perrinebeurier/BMI-EMG-HW/Board V4/DecodingBoard/3D models KiCad/FTSH-107-01-L-D-RA.stp

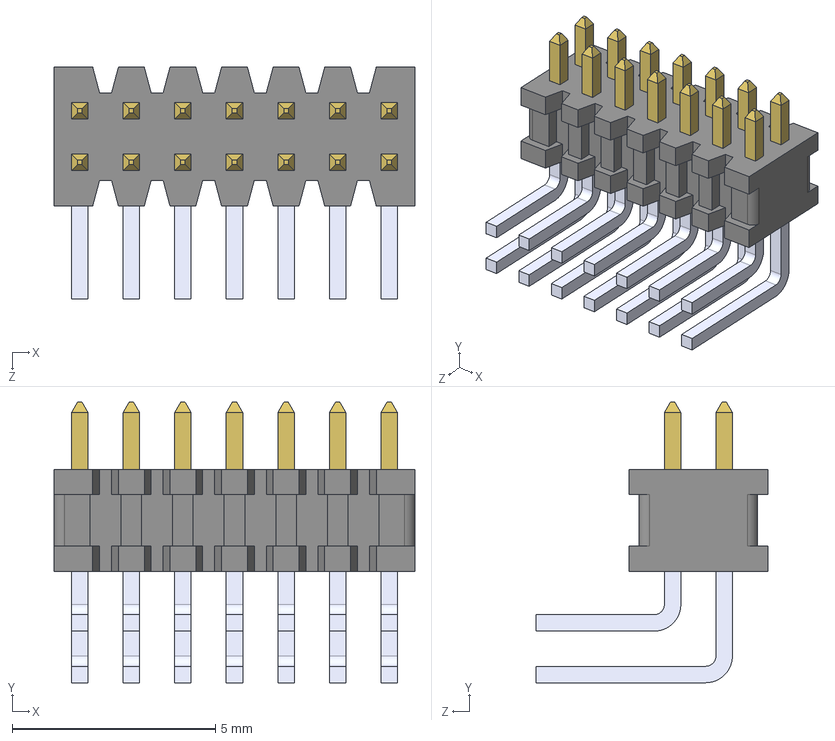
[picture p1: CAD file, 2026-10-09]
Board V4/DecodingBoard/3D models KiCad/FTSH-107-01-L-D-RA.stp
8.89 x 6.91 x 5.71 mm
