perrinebeurier/BMI-EMG-HW/Board V4/DecodingBoard/3D models KiCad/ESDS302DBVR.stp

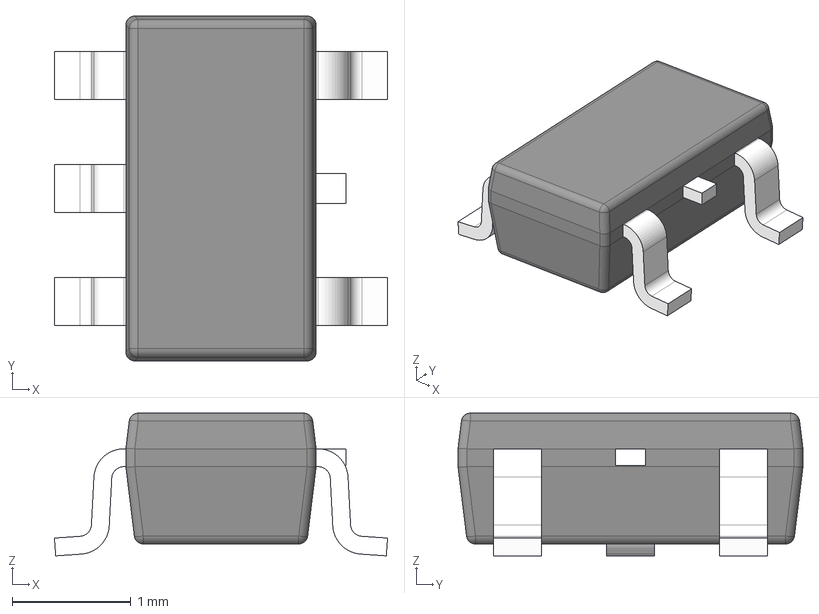
[picture p2: CAD file, 2026-10-08]
Board V4/DecodingBoard/3D models KiCad/ESDS302DBVR.stp
2.80 x 2.90 x 1.20 mm
BODY-SOT
LEAD-SOT x 5
LEAD-DUMMY
