perrinebeurier/BMI-EMG-HW/Board V4/DecodingBoard/3D models KiCad/CX2016DB32000D0FLJCC.stp

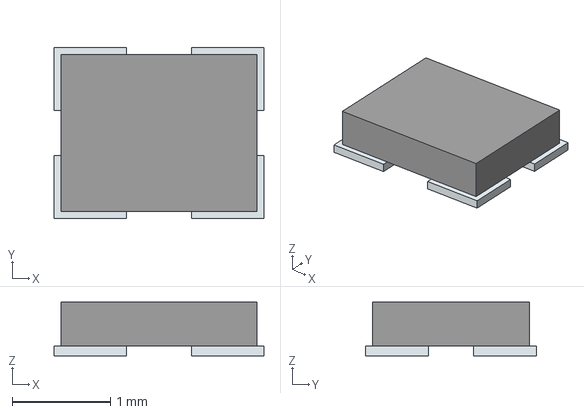
[picture p3: CAD file, 2026-10-08]
Board V4/DecodingBoard/3D models KiCad/CX2016DB32000D0FLJCC.stp
2.14 x 1.74 x 0.55 mm
Pins
