perrinebeurier/BMI-EMG-HW/Board V4/DecodingBoard/3D models KiCad/TL3305BF100QG.stp

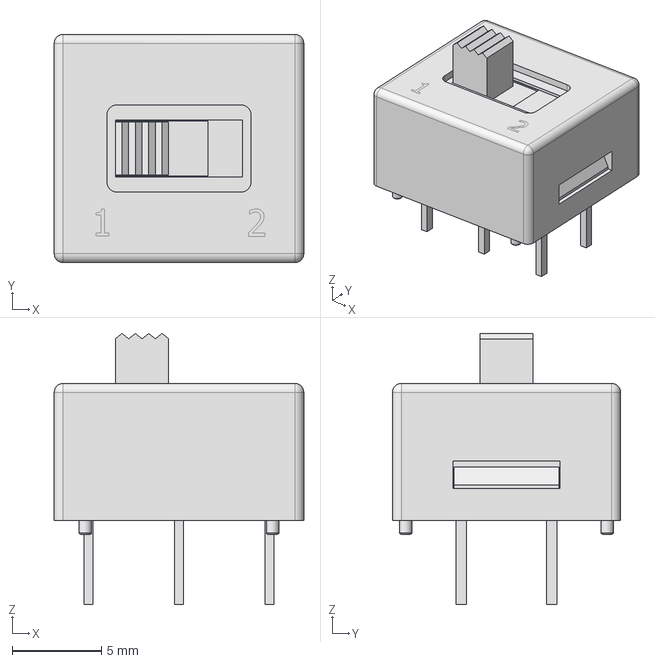
[picture p4: CAD file, 2026-10-08]
Board V4/DecodingBoard/3D models KiCad/TL3305BF100QG.stp
14.0 x 12.8 x 15.2 mm
