perrinebeurier/BMI-EMG-HW/Board V4/DecodingBoard/3D models KiCad/TPS7A7200RGWT.stp

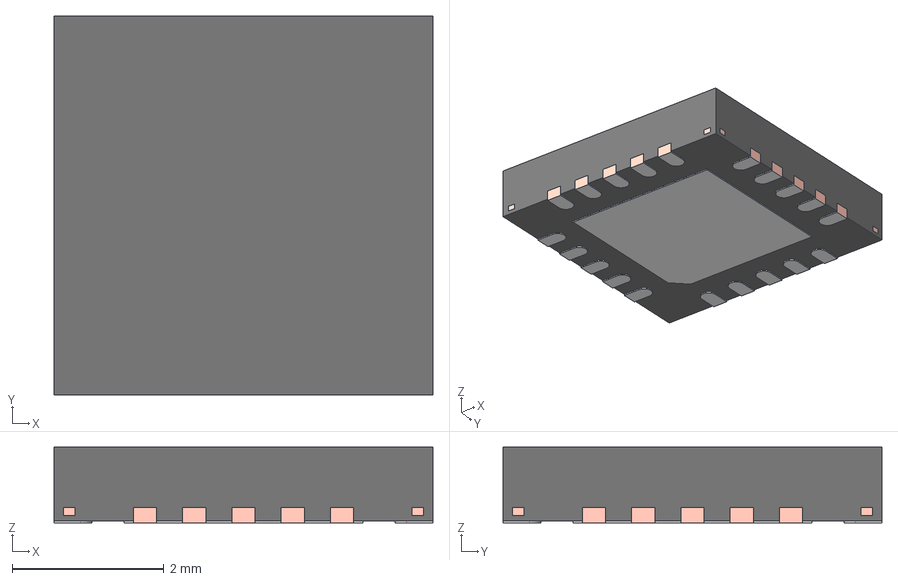
[picture p5: CAD file, 2026-10-08]
Board V4/DecodingBoard/3D models KiCad/TPS7A7200RGWT.stp
5.00 x 5.00 x 1.00 mm
FRAME
PIN1_AREA
