perrinebeurier/BMI-EMG-HW/Board V4/DecodingBoard/3D models KiCad/UJ20-C-H-G-SMT-1-P16-TR.step

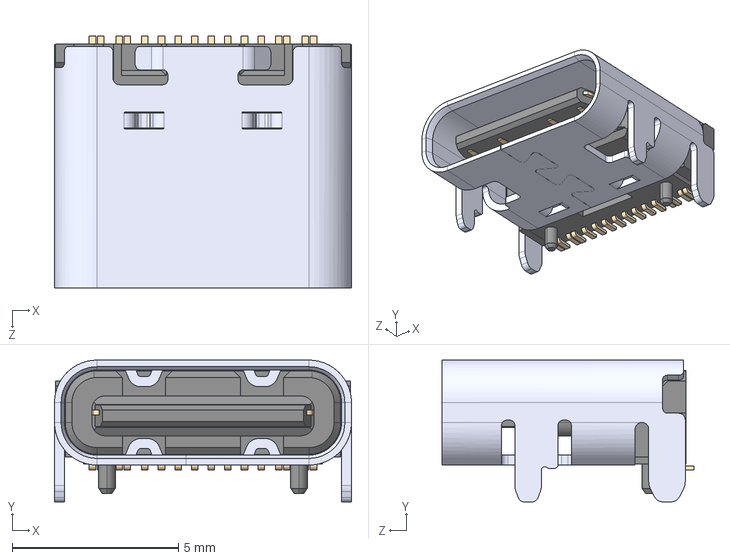
[picture p6: CAD file, 2026-10-08]
Board V4/DecodingBoard/3D models KiCad/UJ20-C-H-G-SMT-1-P16-TR.step
8.94 x 4.27 x 7.60 mm
