perrinebeurier/BMI-EMG-HW/Board V4/DecodingBoard/3D models KiCad/TPS2121RUXR.stp

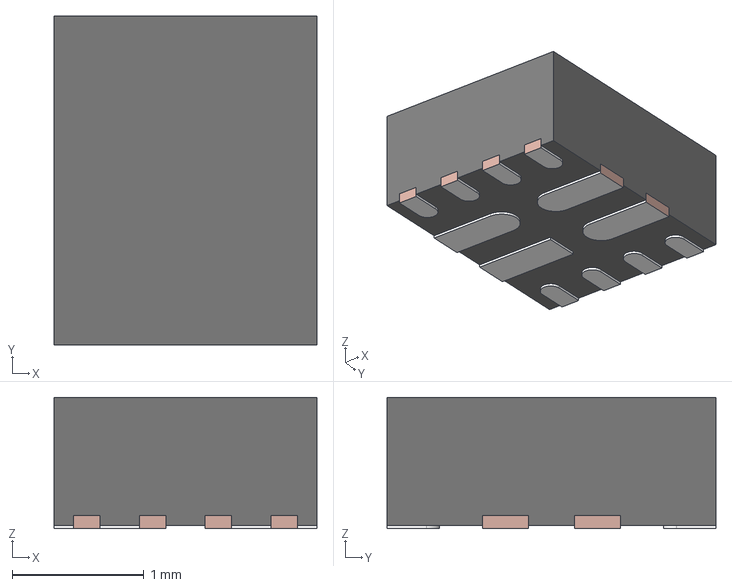
[picture p7: CAD file, 2026-10-08]
Board V4/DecodingBoard/3D models KiCad/TPS2121RUXR.stp
2.00 x 2.50 x 1.00 mm
FRAME
MOLD
