perrinebeurier/BMI-EMG-HW/Board V4/DecodingBoard/3D models KiCad/STM32WBA65CIU6.stp

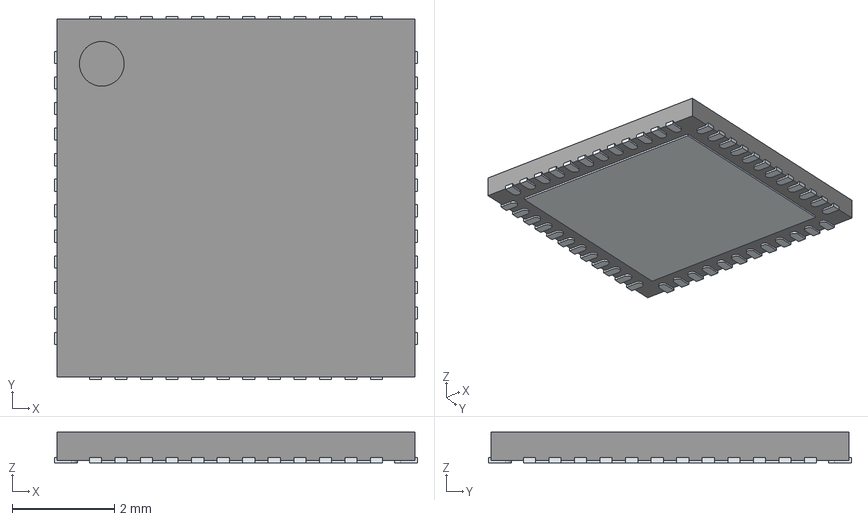
[picture p8: CAD file, 2026-10-08]
Board V4/DecodingBoard/3D models KiCad/STM32WBA65CIU6.stp
7.10 x 7.10 x 0.6 mm
ThermalPin
PinsArrayLR
PinsArrayTB
