perrinebeurier/BMI-EMG-HW/Board V4/DecodingBoard/3D models KiCad/TO-92_MC_MCH.step

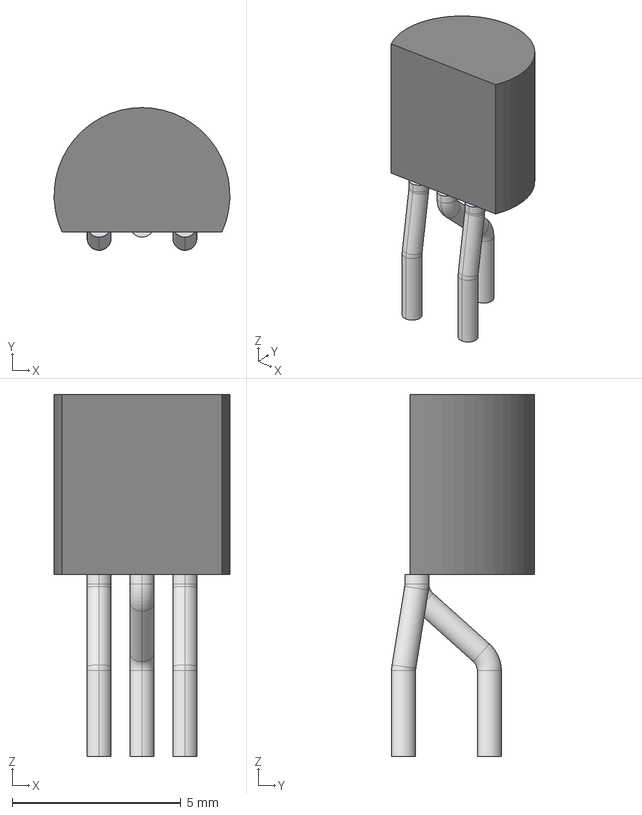
[picture p9: CAD file, 2026-10-08]
Board V4/DecodingBoard/3D models KiCad/TO-92_MC_MCH.step
5.20 x 4.23 x 10.7 mm
