perrinebeurier/BMI-EMG-HW/Board V4/DecodingBoard/3D models KiCad/RN4871-V_RM140.stp

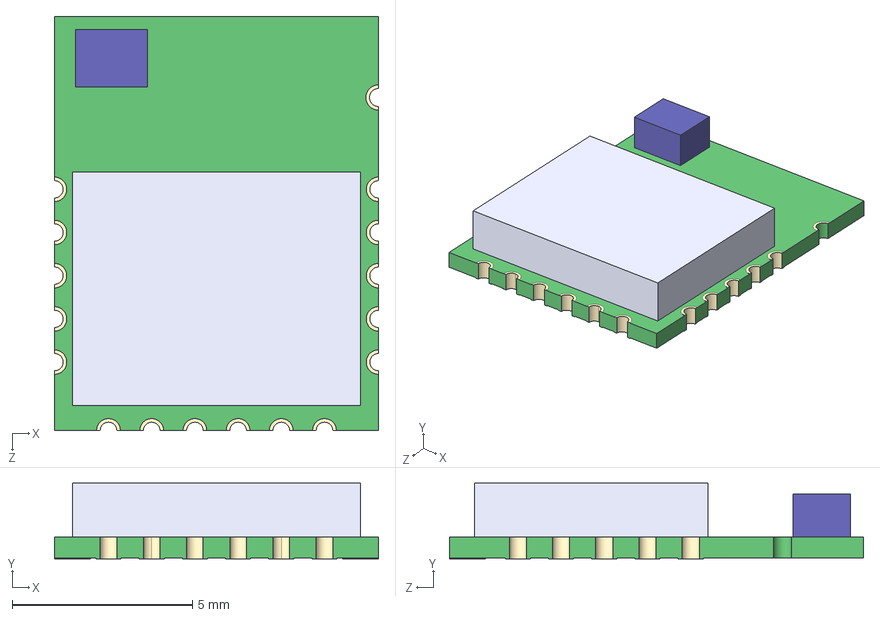
[picture p10: CAD file, 2026-10-08]
Board V4/DecodingBoard/3D models KiCad/RN4871-V_RM140.stp
9.00 x 2.10 x 11.5 mm
