perrinebeurier/BMI-EMG-HW/Board V4/DecodingBoard/3D models KiCad/TSM-106-02-T-SH-LC.step

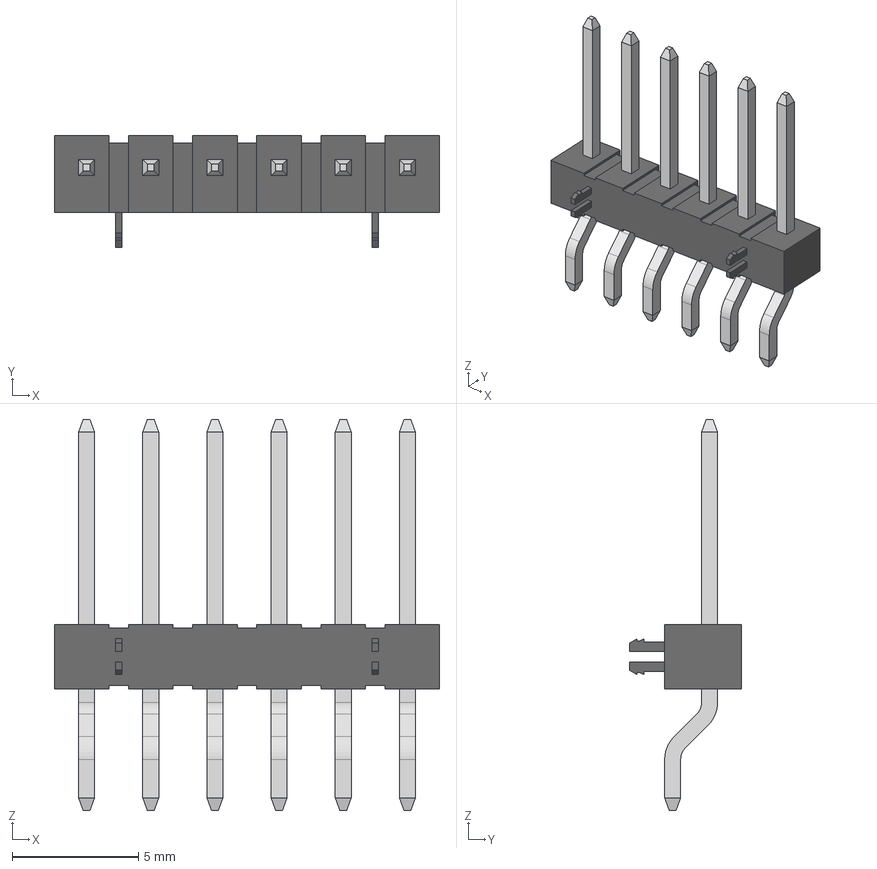
[picture p11: CAD file, 2026-10-08]
Board V4/DecodingBoard/3D models KiCad/TSM-106-02-T-SH-LC.step
15.2 x 4.44 x 15.5 mm
TSM-106-02-SH-LC_body
T-1S6-15-T(-02-6-SH)
T-1S6-15-T(-02-6-SH)2
