perrinebeurier/BMI-EMG-HW/Board V4/DecodingBoard/3D models KiCad/TL3305BFxxxxG.stp

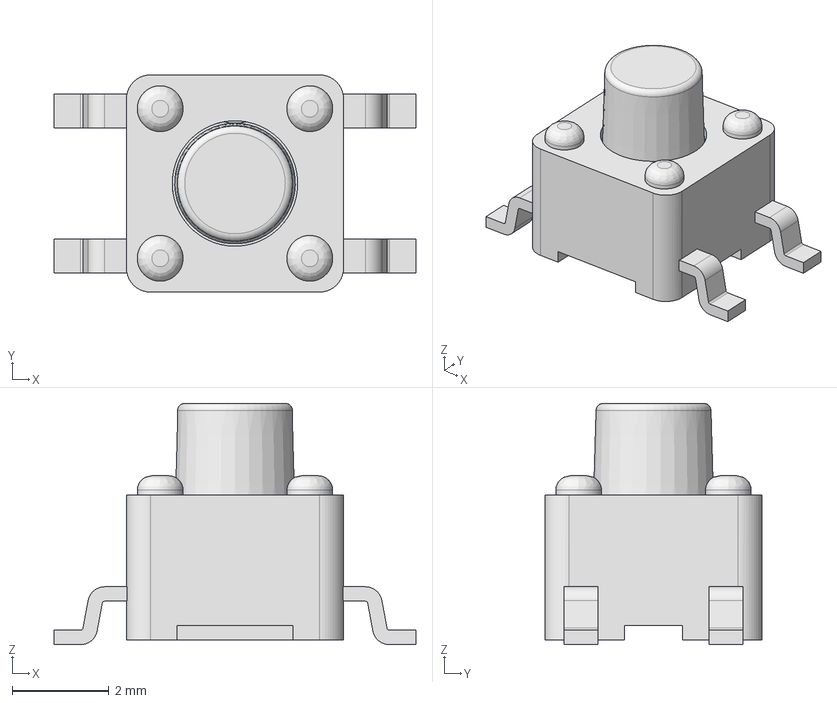
[picture p12: CAD file, 2026-10-08]
Board V4/DecodingBoard/3D models KiCad/TL3305BFxxxxG.stp
7.50 x 4.50 x 5.00 mm
