perrinebeurier/BMI-EMG-HW/Board V4/DecodingBoard/3D models KiCad/2053380002.stp

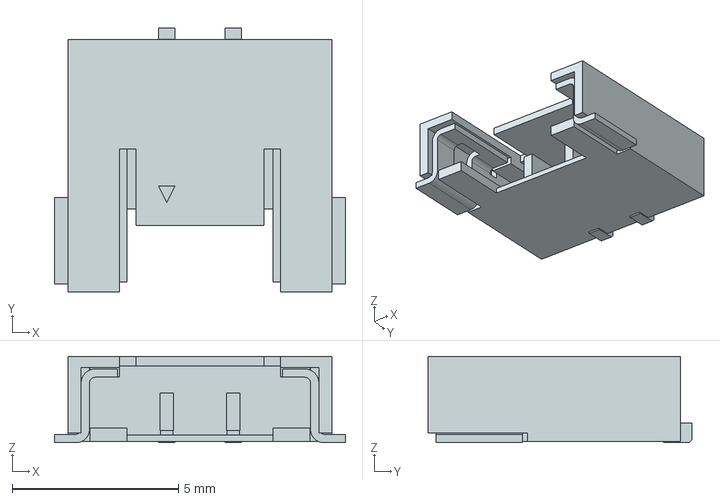
[picture p13: CAD file, 2026-10-08]
Board V4/DecodingBoard/3D models KiCad/2053380002.stp
8.75 x 7.95 x 2.60 mm
