perrinebeurier/BMI-EMG-HW/Board V4/DecodingBoard/3D models KiCad/5037630491.stp

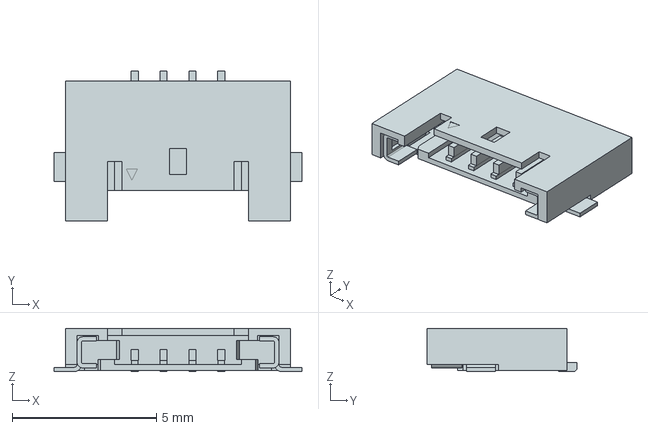
[picture p14: CAD file, 2026-10-08]
Board V4/DecodingBoard/3D models KiCad/5037630491.stp
8.60 x 5.19 x 1.50 mm
