perrinebeurier/BMI-EMG-HW/Board V4/DecodingBoard/3D models KiCad/5040500491.stp

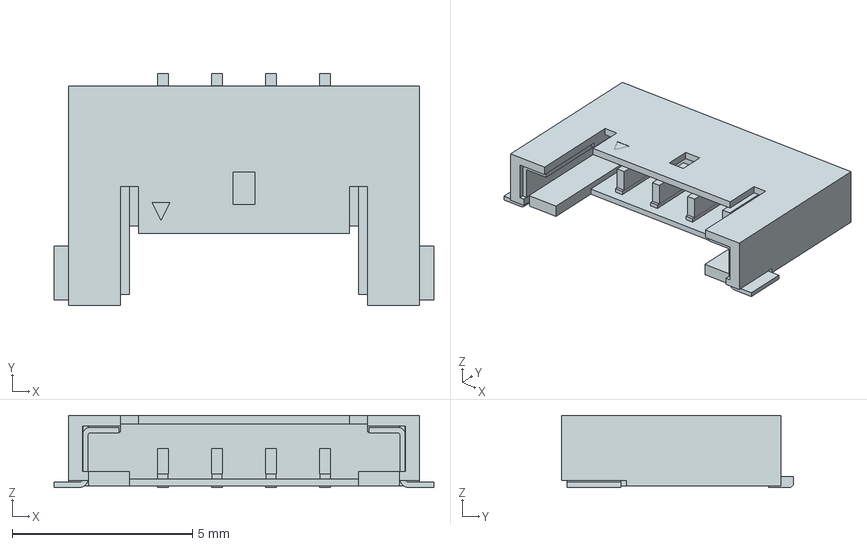
[picture p15: CAD file, 2026-10-08]
Board V4/DecodingBoard/3D models KiCad/5040500491.stp
10.6 x 6.44 x 2.00 mm
