perrinebeurier/BMI-EMG-HW/Board V4/DecodingBoard/DecodingBoard.kicad_pcb

## KiCad design Board V4/DecodingBoard/DecodingBoard.kicad_pcb (2026-10-09)

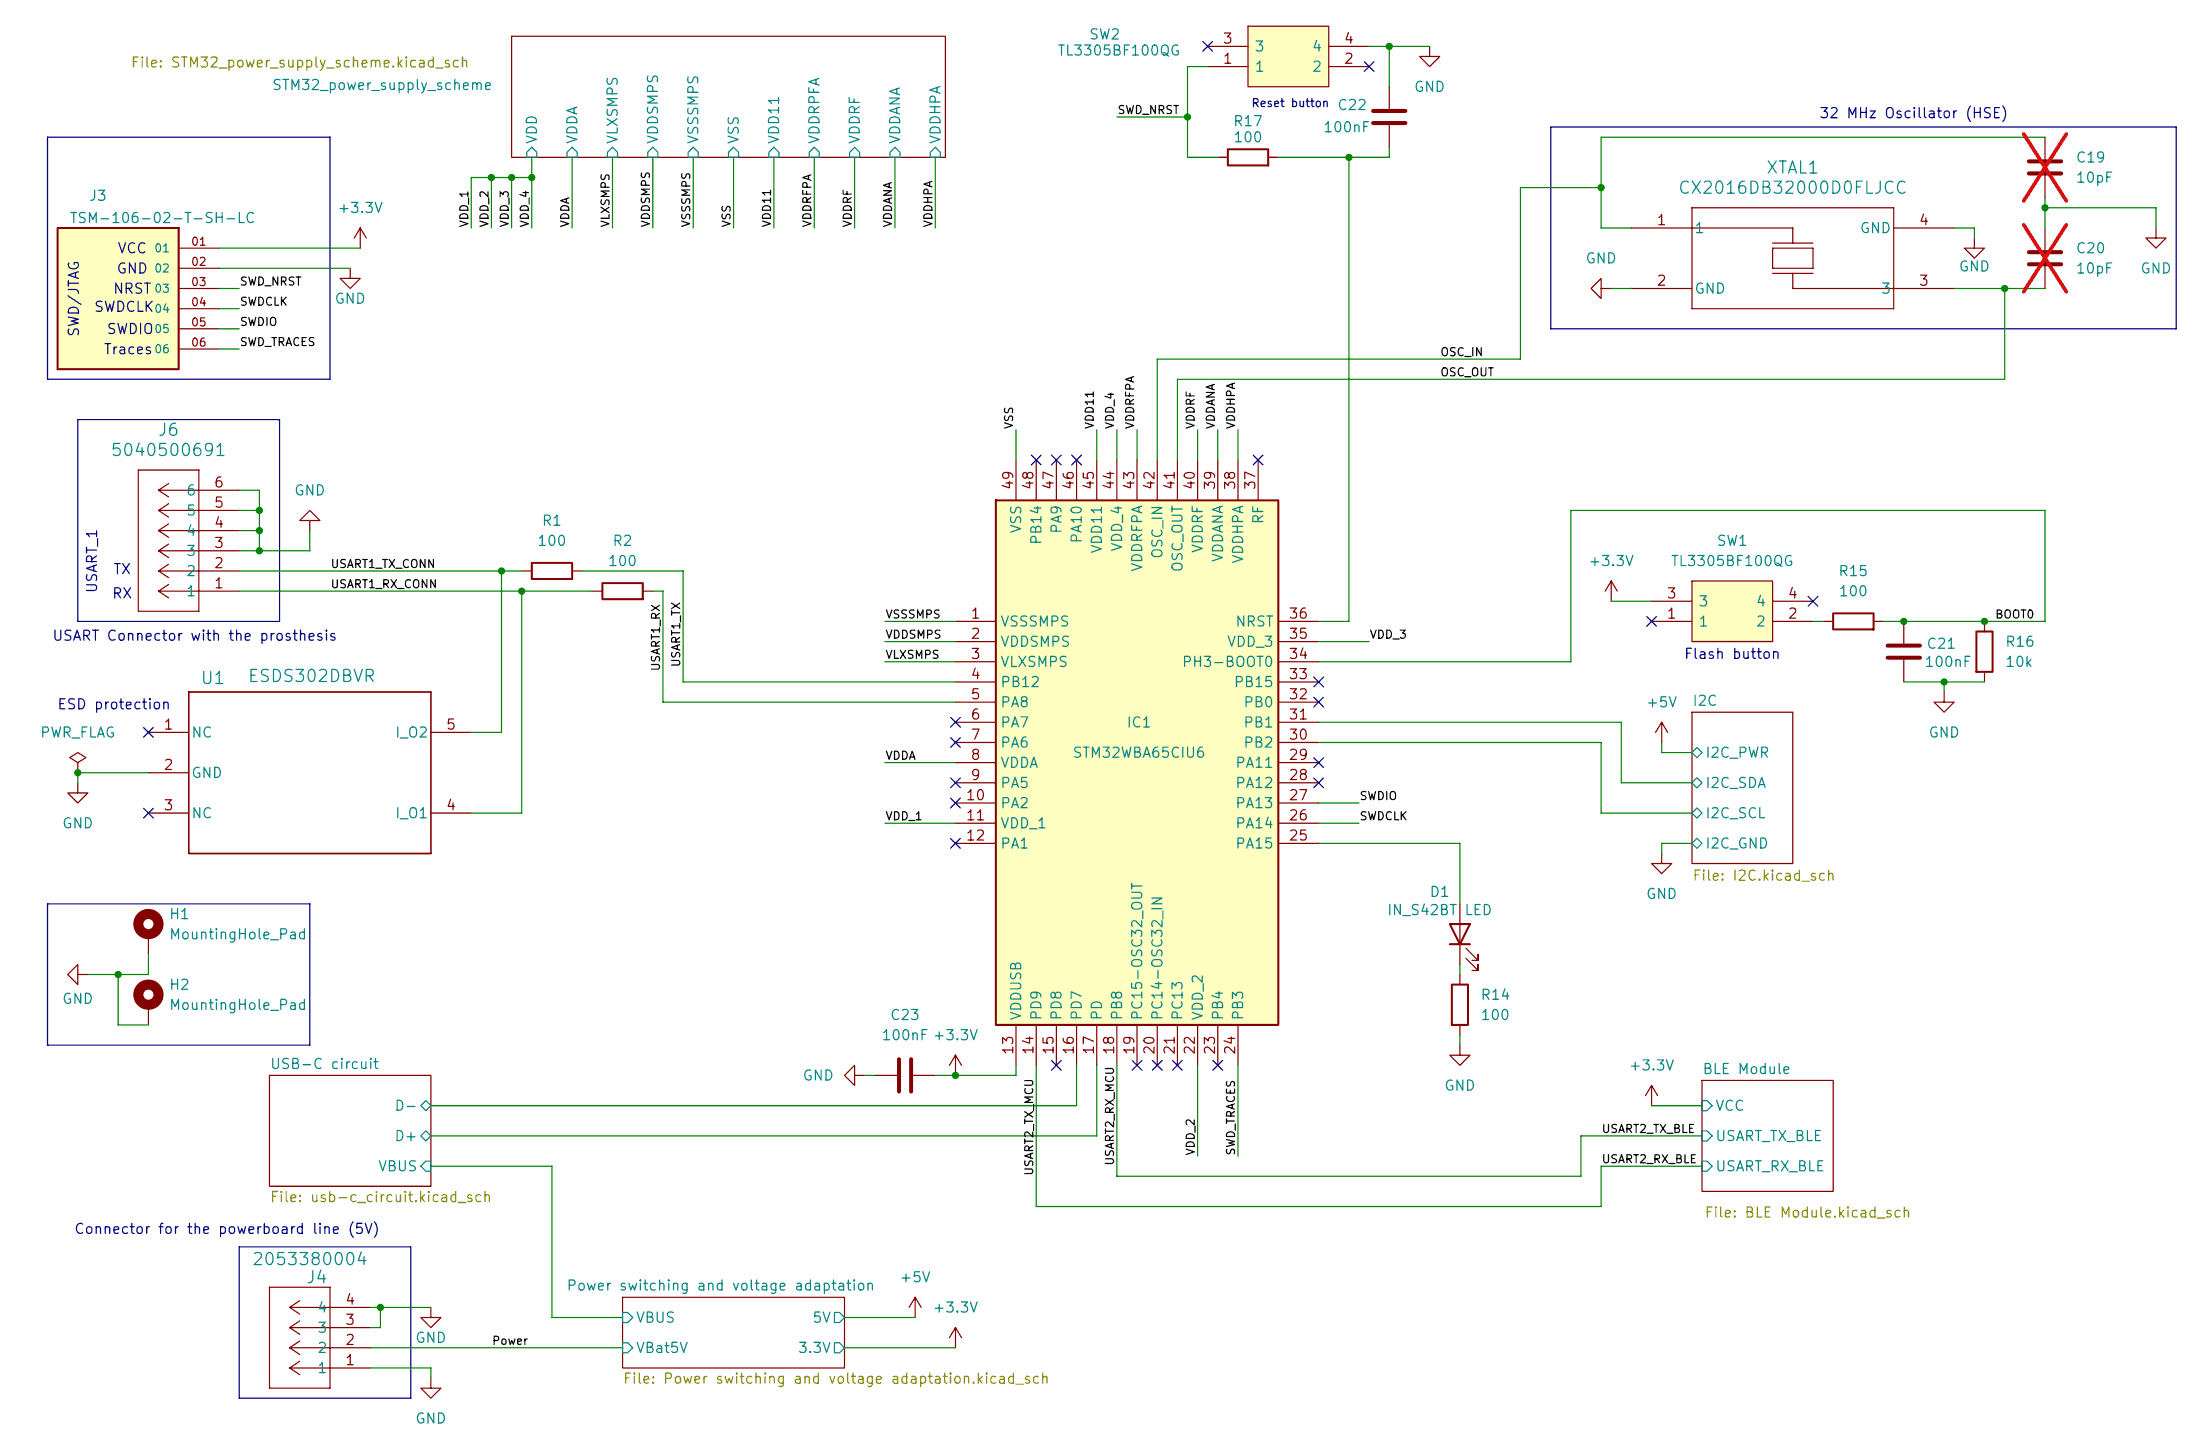
[picture p16: schematic DecodingBoard.kicad_sch, Decoding Board]

Parts:
C19, C20: 10pF; C_0603_1608Metric; not fitted
C21, C22, C23: 100nF; C_0402_1005Metric
D1: IN_S42BT LED; LED_0402_1005Metric
H1, H2: MountingHole_Pad; MountingHole_2.2mm_M2_DIN965_Pad
IC1: STM32WBA65CIU6; QFN50P700X700X60-49N-D; Manufacturer_Part_Number STM32WBA65CIU6; Mouser Part Number 511-STM32WBA65CIU6
J3: TSM-106-02-T-SH-LC; SAMTEC_TSM-106-02-T-SH-LC; PARTREV R
J4: 2053380004; CONN_2053380000-SD_02_MOL
J6: 5040500691; CONN_5040500491_MOL
R1, R2, R14, R15, R17: 100; R_0402_1005Metric
R16: 10k; R_0402_1005Metric
SW1, SW2: TL3305BF100QG; TL3305BF160QG; Mouser Part Number 612-TL3305BF100QG
U1: ESDS302DBVR; SOT95P280X145-5N; Mouser Part Number 595-ESDS302DBVR
XTAL1: CX2016DB32000D0FLJCC; Mouser Part Number 581-CX2016DB32DFLJCC

Connections:
+3.3V: C23.2, IC1.2 (VDDSMPS), IC1.8 (VDDA), IC1.11 (VDD_1), IC1.13 (VDDUSB), IC1.22 (VDD_2), IC1.35 (VDD_3), IC1.40 (VDDRF), IC1.44 (VDD_4), J3.01, SW1.3; also elsewhere on the board
/BOOT0: C21.1, IC1.34 (PH3-BOOT0), R15.2, R16.1
/I2C/I2C_SCL: IC1.30 (PB2); also elsewhere on the board
/I2C/I2C_SDA: IC1.31 (PB1); also elsewhere on the board
/OSC_IN: C19.1, IC1.42 (OSC_IN), XTAL1.1
/OSC_OUT: C20.2, IC1.41 (OSC_OUT), XTAL1.3
/Power: J4.2; also elsewhere on the board
/SWDCLK: IC1.26 (PA14), J3.04
/SWDIO: IC1.27 (PA13), J3.05
/SWD_NRST: J3.03, R17.1, SW2.1
/SWD_TRACES: IC1.24 (PB3), J3.06
/USART1_RX: IC1.5 (PA8), R2.2
/USART1_RX_CONN: J6.1, R2.1, U1.4 (I_O1)
/USART1_TX: IC1.4 (PB12), R1.2
/USART1_TX_CONN: J6.2, R1.1, U1.5 (I_O2)
/USART2_RX_BLE: IC1.14 (PD9); also elsewhere on the board
/USART2_RX_MCU: IC1.18 (PB8); also elsewhere on the board
/USB-C circuit/D+: IC1.17 (PD); also elsewhere on the board
/USB-C circuit/D-: IC1.16 (PD7); also elsewhere on the board
/VDD11: IC1.39 (VDDANA), IC1.43 (VDDRFPA), IC1.45 (VDD11); also elsewhere on the board
/VDDHPA: IC1.38 (VDDHPA); also elsewhere on the board
/VLXSMPS: IC1.3 (VLXSMPS); also elsewhere on the board
GND: C19.2, C20.1, C21.2, C22.2, C23.1, H1.1 (1_1), H2.1 (1_1), IC1.1 (VSSSMPS), IC1.49 (VSS), J3.02, J4.1, J4.3, J4.4, J6.3, J6.4, J6.5, J6.6, R14.2, R16.2, SW2.4, U1.2 (GND), XTAL1.2 (GND), XTAL1.4 (GND); also elsewhere on the board
unnamed: D1.2 (A), IC1.25 (PA15)
unnamed: D1.1 (K), R14.1
unnamed: C22.1, IC1.36 (NRST), R17.2
unnamed: R15.1, SW1.2

Notes on the sheet:
GND
SWDIO
Flash button
NRST
ESD protection
Traces
USART Connector with the prosthesis
USART_1
SWD/JTAG
Connector for the powerboard line (5V)
SWDCLK
VCC
Reset button
32 MHz Oscillator (HSE)

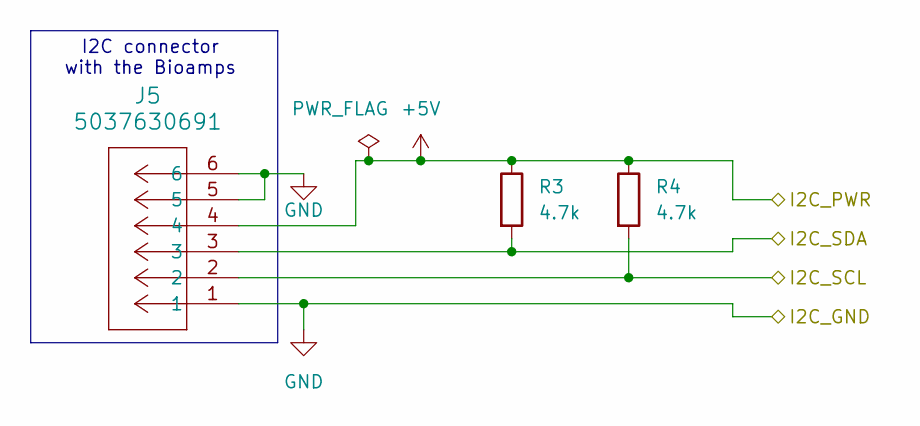
[picture p17: schematic I2C.kicad_sch]

Parts:
J5: 5037630691; CONN_5037630000-SD_04_MOL
R3, R4: 4.7k; R_0603_1608Metric

Connections:
+5V: J5.4, R3.1, R4.1; also elsewhere on the board
/I2C/I2C_SCL: J5.2, R4.2; also elsewhere on the board
/I2C/I2C_SDA: J5.3, R3.2; also elsewhere on the board
GND: J5.1, J5.5, J5.6; also elsewhere on the board

Notes on the sheet:
I2C connector with the Bioamps

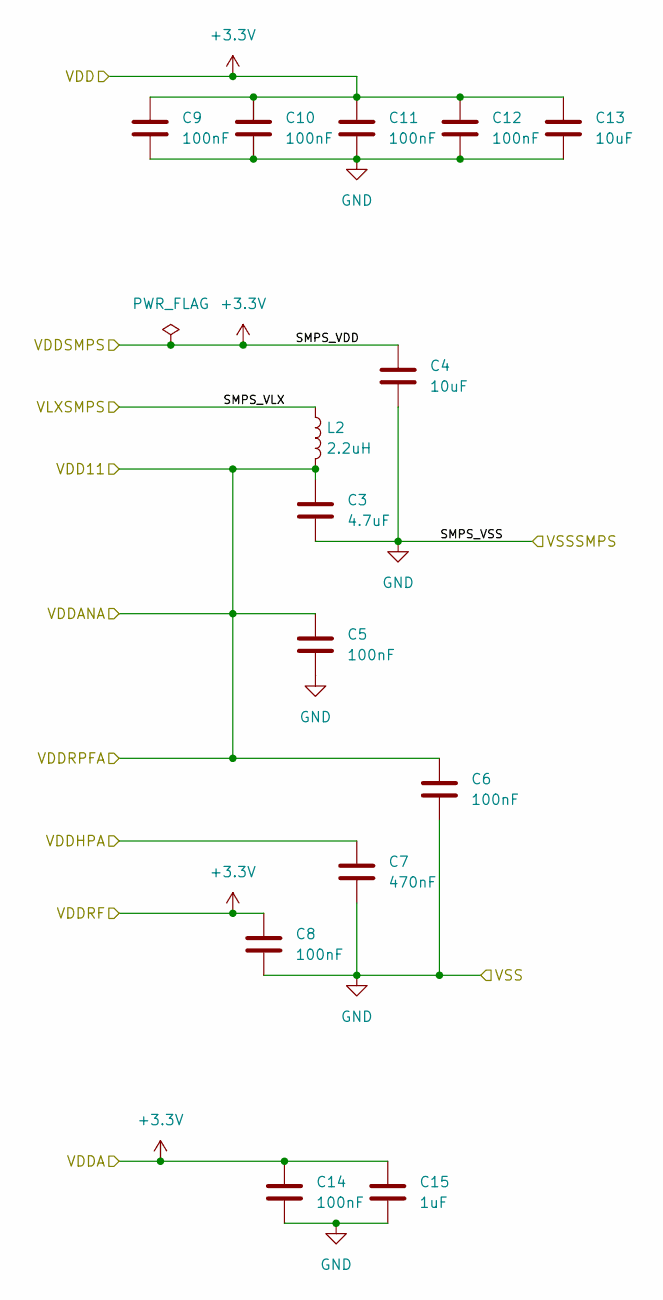
[picture p18: schematic STM32_power_supply_scheme.kicad_sch, STM32 Power Supply Scheme]

Parts:
C3: 4.7uF; C_0603_1608Metric
C4, C13: 10uF; C_0603_1608Metric
C5, C6, C8, C9, C10, C11, C12, C14: 100nF; C_0402_1005Metric
C7: 470nF; C_0402_1005Metric
C15: 1uF; C_0402_1005Metric
L2: 2.2uH; L_0805_2012Metric

Connections:
+3.3V: C4.1, C8.1, C9.1, C10.1, C11.1, C12.1, C13.1, C14.1, C15.1; also elsewhere on the board
/VDD11: C3.1, C5.1, C6.1, L2.2; also elsewhere on the board
/VDDHPA: C7.1; also elsewhere on the board
/VLXSMPS: L2.1; also elsewhere on the board
GND: C3.2, C4.2, C5.2, C6.2, C7.2, C8.2, C9.2, C10.2, C11.2, C12.2, C13.2, C14.2, C15.2; also elsewhere on the board

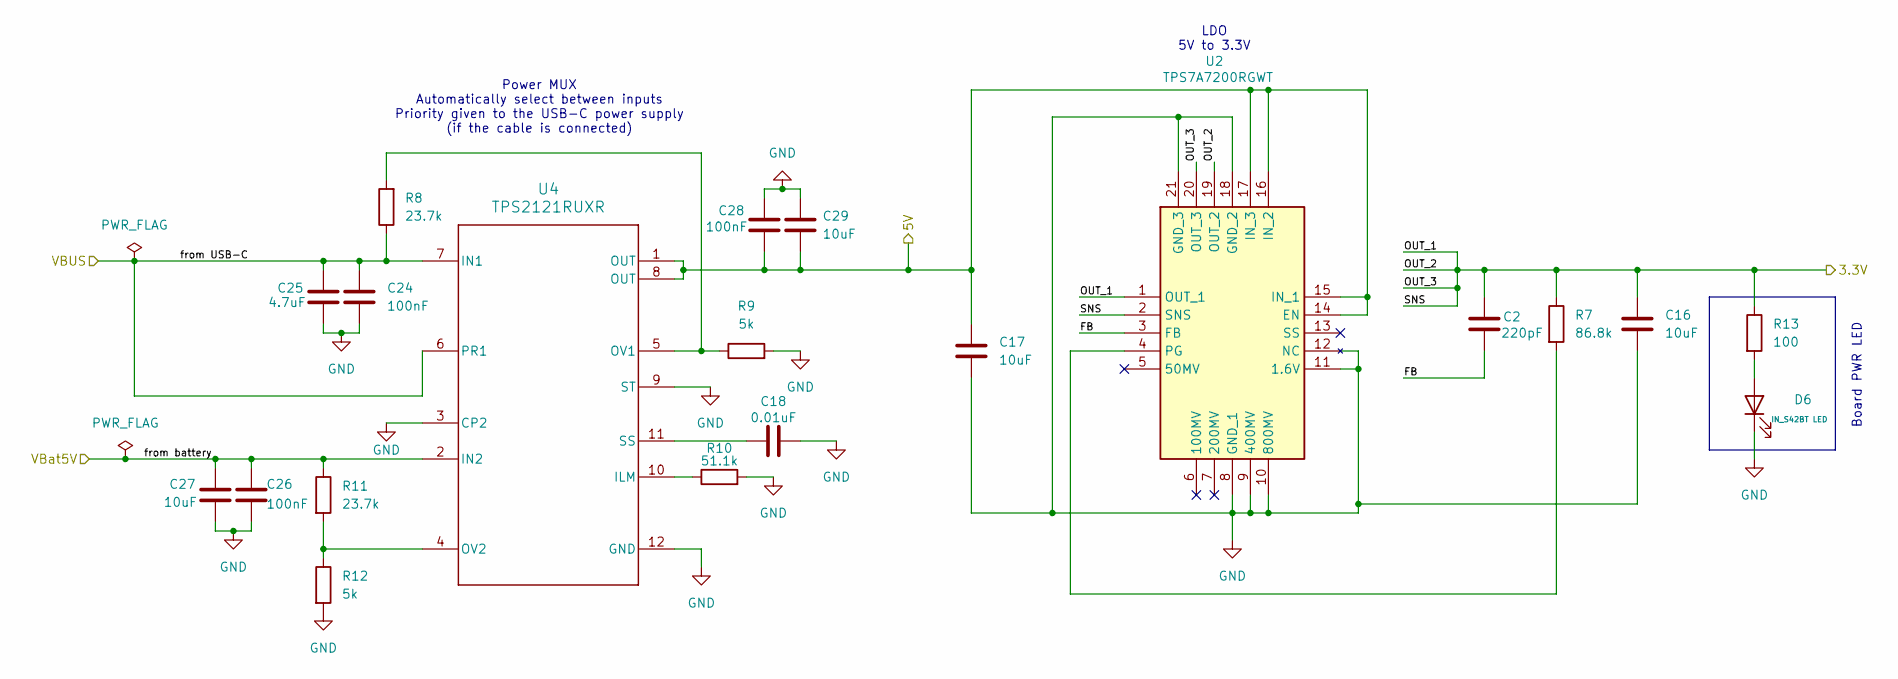
[picture p19: schematic Power switching and voltage adaptation.kicad_sch]

Parts:
C2: 220pF; C_0402_1005Metric
C16, C17, C27, C29: 10uF; C_0603_1608Metric
C18: 0.01uF; C_0402_1005Metric
C24, C26, C28: 100nF; C_0402_1005Metric
C25: 4.7uF; C_0603_1608Metric
D6: IN_S42BT LED; LED_0402_1005Metric
R7: 86.8k; R_0603_1608Metric
R8, R11: 23.7k; R_0402_1005Metric
R9, R12: 5k; R_0402_1005Metric
R10: 51.1k; R_0402_1005Metric
R13: 100; R_0402_1005Metric
U2: TPS7A7200RGWT; QFN65P500X500X100-21N-D; Manufacturer_Part_Number TPS7A7200RGWT; Mouser Part Number 595-TPS7A7200RGWT
U4: TPS2121RUXR; Mouser Part Number 595-TPS2121RUXR

Connections:
+3.3V: C2.1, C16.1, R7.1, R13.1, U2.1 (OUT_1), U2.2 (SNS), U2.19 (OUT_2), U2.20 (OUT_3); also elsewhere on the board
+5V: C17.1, C28.2, C29.2, U2.14 (EN), U2.15 (IN_1), U2.16 (IN_2), U2.17 (IN_3), U4.1 (OUT), U4.8 (OUT); also elsewhere on the board
/Power: C26.1, C27.1, R11.1, U4.2 (IN2); also elsewhere on the board
/Power switching and voltage adaptation/FB: C2.2, U2.3 (FB)
/Power switching and voltage adaptation/from USB-C: C24.1, C25.1, R8.1, U4.6 (PR1), U4.7 (IN1); also elsewhere on the board
GND: C16.2, C17.2, C18.2, C24.2, C25.2, C26.2, C27.2, C28.1, C29.1, D6.1 (K), R9.2, R10.2, R12.2, U2.8 (GND_1), U2.9 (400MV), U2.10 (800MV), U2.11 (1.6V), U2.12 (NC), U2.18 (GND_2), U2.21 (GND_3), U4.3 (CP2), U4.9 (ST), U4.12 (GND); also elsewhere on the board
unnamed: D6.2 (A), R13.2
unnamed: R7.2, U2.4 (PG)
unnamed: R10.1, U4.10 (ILM)
unnamed: R8.2, R9.1, U4.5 (OV1)
unnamed: R11.2, R12.1, U4.4 (OV2)
unnamed: C18.1, U4.11 (SS)

Notes on the sheet:
Power MUX Automatically select between inputs Priority given to the USB-C power supply (if the cable is connected)
LDO 5V to 3.3V
Board PWR LED

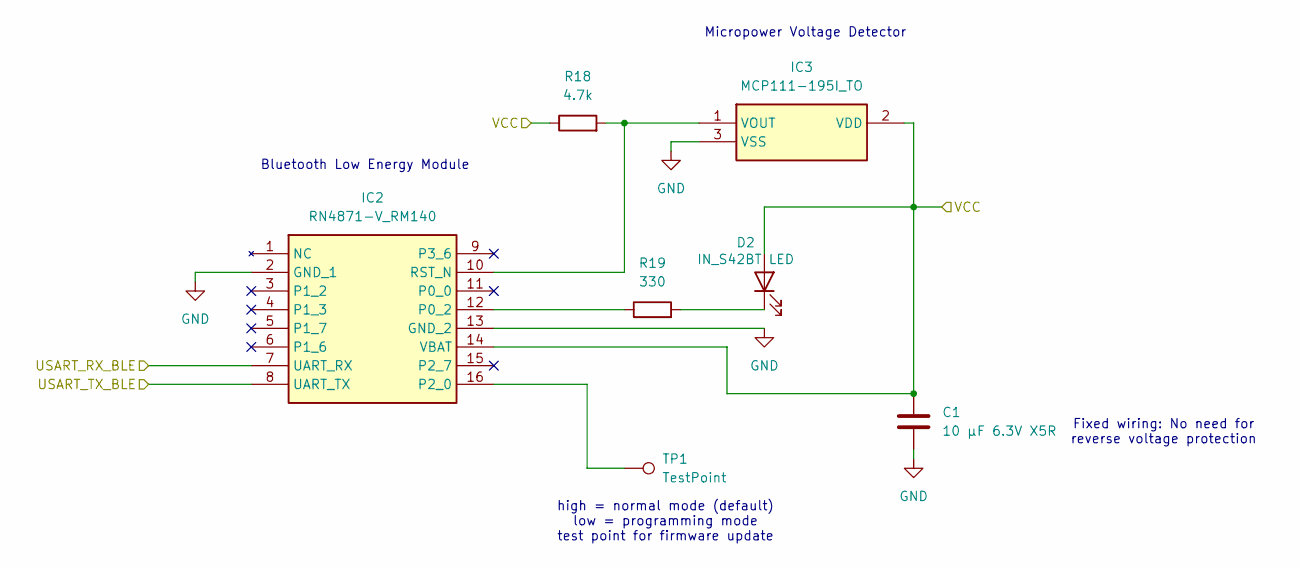
[picture p20: schematic BLE Module.kicad_sch, RF circuitry & antennas]

Parts:
C1: 10 μF 6.3V X5R; C_0805_2012Metric
D2: IN_S42BT LED; LED_0402_1005Metric
IC2: RN4871-V_RM140; RN4871VRM140; Manufacturer_Part_Number RN4871-V/RM140; Mouser Part Number 579-RN4871-V/RM140
IC3: MCP111-195I_TO; LR645N3GP013; Manufacturer_Part_Number MCP111-195I/TO; Mouser Part Number 579-MCP111-195I/TO
R18: 4.7k; R_0402_1005Metric
R19: 330; R_0402_1005Metric
TP1: TestPoint; TestPoint_Pad_D1.0mm

Connections:
+3.3V: C1.1, D2.2 (A), IC2.14 (VBAT), IC3.2 (VDD), R18.1; also elsewhere on the board
/USART2_RX_BLE: IC2.7 (UART_RX); also elsewhere on the board
/USART2_RX_MCU: IC2.8 (UART_TX); also elsewhere on the board
GND: C1.2, IC2.2 (GND_1), IC2.13 (GND_2), IC3.3 (VSS); also elsewhere on the board
unnamed: D2.1 (K), R19.2
unnamed: IC2.12 (P0_2), R19.1
unnamed: IC2.16 (P2_0), TP1.1 (1_1)
unnamed: IC2.10 (RST_N), IC3.1 (VOUT), R18.2

Notes on the sheet:
Bluetooth Low Energy Module
high = normal mode (default) low = programming mode test point for firmware update
Fixed wiring: No need for reverse voltage protection
Micropower Voltage Detector

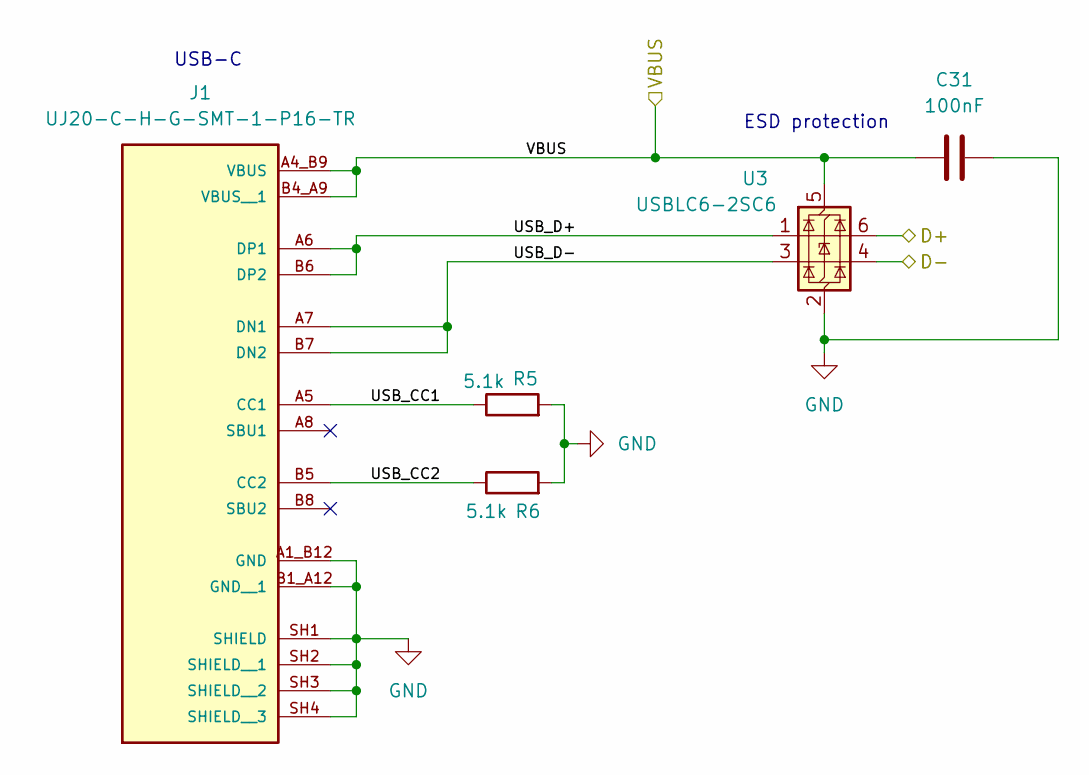
[picture p21: schematic usb-c_circuit.kicad_sch, USB-C circuit]

Parts:
C31: 100nF; C_0402_1005Metric
J1: UJ20-C-H-G-SMT-1-P16-TR; SAMESKY_UJ20-C-H-G-SMT-1-P16-TR; PARTREV 1.0; Mouser Part Number 179-UJ20CHGSMT1P16TR
R5, R6: 5.1k; R_0402_1005Metric
U3: USBLC6-2SC6; SOT-23-6; Mouser Part Number 511-USBLC6-2SC6

Connections:
/Power switching and voltage adaptation/from USB-C: C31.1, J1.A4_B9 (VBUS), J1.B4_A9 (VBUS__1), U3.5 (VBUS); also elsewhere on the board
/USB-C circuit/D+: U3.6 (I/O1); also elsewhere on the board
/USB-C circuit/D-: U3.4 (I/O2); also elsewhere on the board
/USB-C circuit/USB_CC1: J1.A5 (CC1), R5.1
/USB-C circuit/USB_CC2: J1.B5 (CC2), R6.1
/USB-C circuit/USB_D+: J1.A6 (DP1), J1.B6 (DP2), U3.1 (I/O1)
/USB-C circuit/USB_D-: J1.A7 (DN1), J1.B7 (DN2), U3.3 (I/O2)
GND: C31.2, J1.A1_B12 (GND), J1.B1_A12 (GND__1), J1.SH1 (SHIELD), J1.SH2 (SHIELD__1), J1.SH3 (SHIELD__2), J1.SH4 (SHIELD__3), R5.2, R6.2, U3.2 (GND); also elsewhere on the board

Notes on the sheet:
ESD protection
USB-C

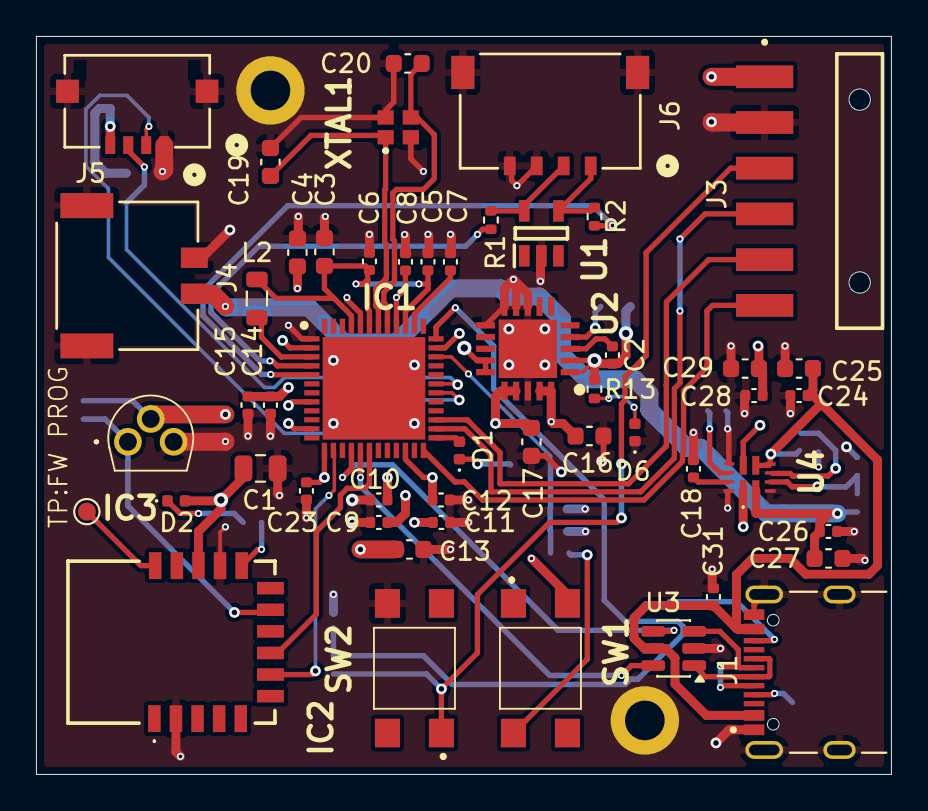
[picture p22: board DecodingBoard.kicad_pcb from above]

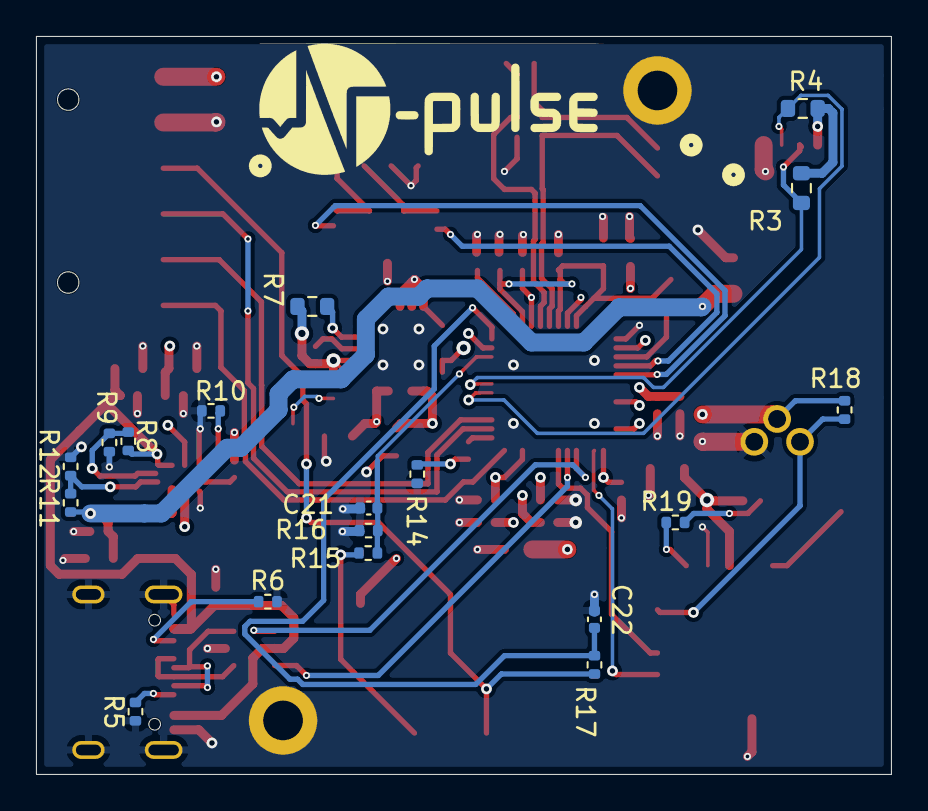
[picture p23: board DecodingBoard.kicad_pcb from below]

Board: 4 copper layers, 47.5 x 41.0 mm, 71 parts (18 on the bottom side), 44 nets.
