perrinebeurier/BMI-EMG-HW/(commit log)

2026-09-30 New files for the Decoding Board V4
    [DecodingBoard.kicad_pcb, DecodingBoard.kicad_sch, I2C.kicad_sch, Power switching and voltage adaptation.kicad_sch, Power_switching_and_voltage_adaptation.kicad_sch, STM32_power_supply_scheme.kicad_sch, untitled.kicad_sch, usb-c_circuit.kicad_sch]
2026-10-01 update to the LDO footprint and C16 from 4.7 uF to 10 uF
    [DecodingBoard.kicad_sch, Power switching and voltage adaptation.kicad_sch]
2026-10-05 Addition of the BLE module and BOM
    [BLE Module.kicad_sch, DecodingBoard.kicad_sch, I2C.kicad_sch, Power switching and voltage adaptation.kicad_sch, Power_switching_and_voltage_adaptation.kicad_sch, RF circuitry & antennas.kicad_sch, STM32_power_supply_scheme.kicad_sch, untitled.kicad_sch]
2026-10-05 footprints updates
    [BLE Module.kicad_sch, DecodingBoard.kicad_pcb, DecodingBoard.kicad_sch, I2C.kicad_sch, Power switching and voltage adaptation.kicad_sch, usb-c_circuit.kicad_sch]
2026-10-08 First version of the layout
    [2053380002.stp, 5037630491.stp, 5040500491.stp, CX2016DB32000D0FLJCC.stp, DecodingBoard.kicad_pcb, DecodingBoard.kicad_sch, ESDS302DBVR.stp, Power switching and voltage adaptation.kicad_sch]
2026-10-09 progress on the layout
    [DecodingBoard.kicad_pcb, DecodingBoard.kicad_sch, FTSH-107-01-L-D-RA.stp, I2C.kicad_sch, TSM-106-02-T-SH-LC.step]
2026-10-09 complete first PCB layout
    [DecodingBoard.kicad_pcb]
