perrinebeurier/BMI-EMG-HW/(notices)

Notices in the files:
Board V4/DecodingBoard/3D models KiCad/TSM-106-02-T-SH-LC.step:
author */ ('License CC BY-ND 4.0'),
